Ranji1908/Reifendruck-Display-Arduino/docs/bilder/v1_retro/2_alarm.png

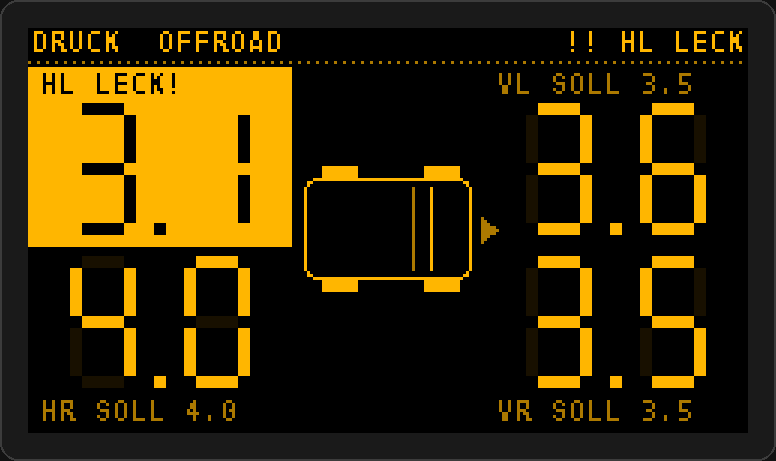
docs/bilder/v1_retro/2_alarm.png
