Ranji1908/Reifendruck-Display-Arduino/docs/bilder/v1_retro/3_temperatur.png

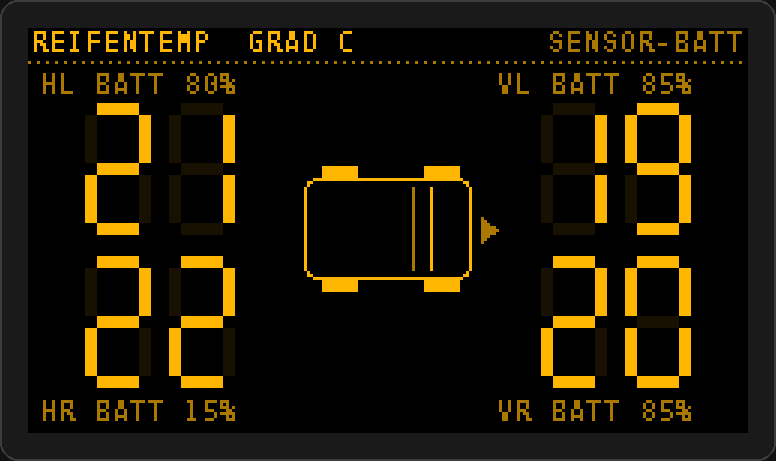
docs/bilder/v1_retro/3_temperatur.png
