Ranji1908/Reifendruck-Display-Arduino/docs/bilder/v1_retro/4_neigung.png

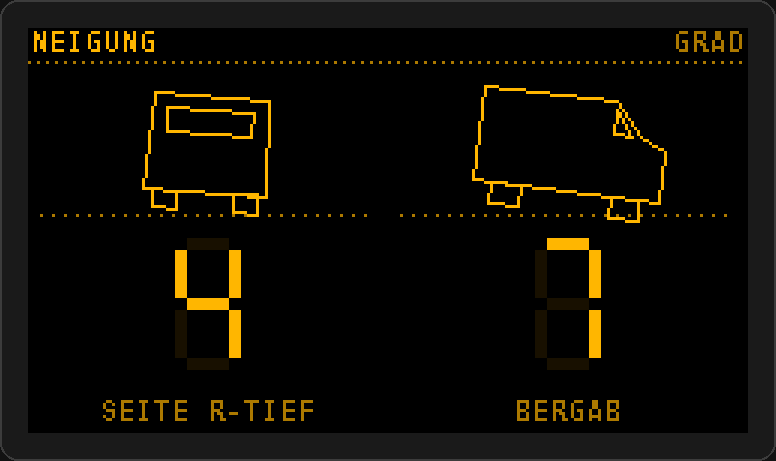
docs/bilder/v1_retro/4_neigung.png
