Ranji1908/Reifendruck-Display-Arduino/docs/bilder/v1_retro/5_kompass.png

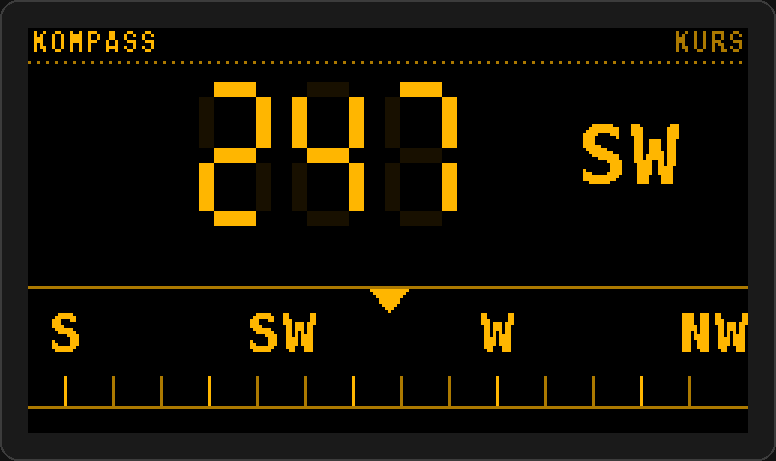
docs/bilder/v1_retro/5_kompass.png
