Ranji1908/Reifendruck-Display-Arduino/docs/bilder/v1_retro/6_bord.png

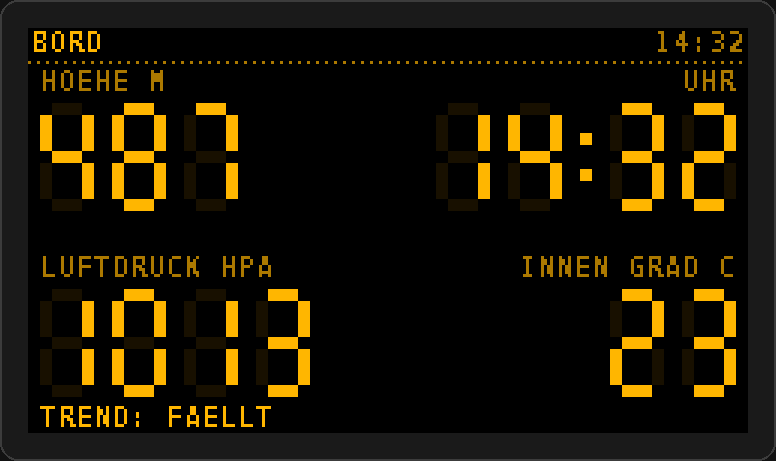
docs/bilder/v1_retro/6_bord.png
