Ranji1908/Reifendruck-Display-Arduino/docs/bilder/v1_retro/7_ausrichten.png

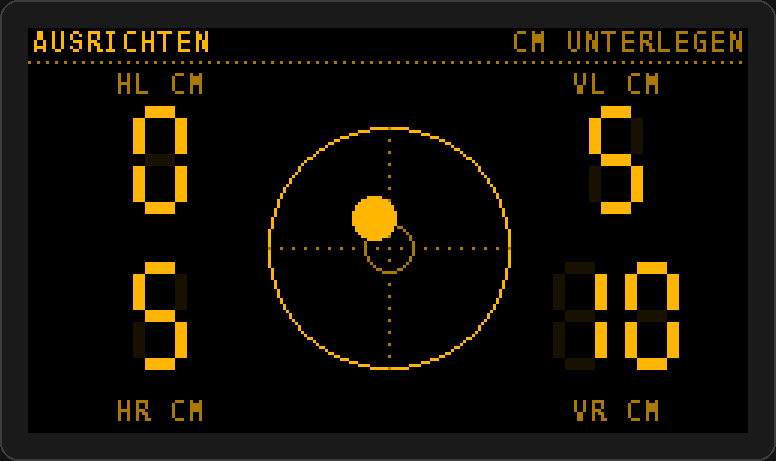
docs/bilder/v1_retro/7_ausrichten.png
