Ranji1908/Reifendruck-Display-Arduino/docs/bilder/v1_retro/8_menue.png

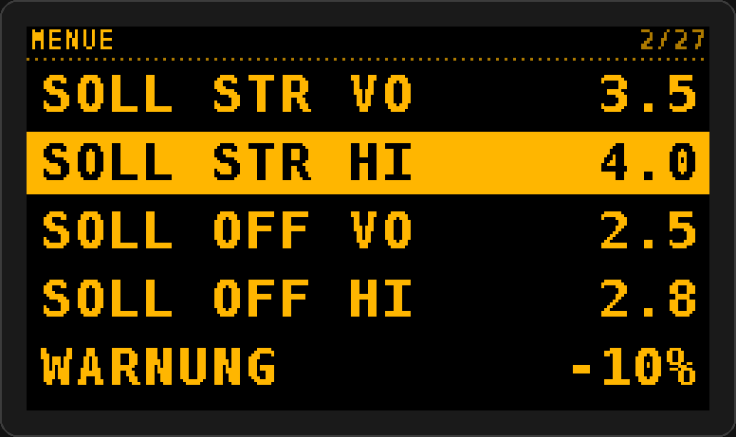
docs/bilder/v1_retro/8_menue.png
