Ranji1908/Reifendruck-Display-Arduino/docs/bilder/v1_retro/9_wert.png

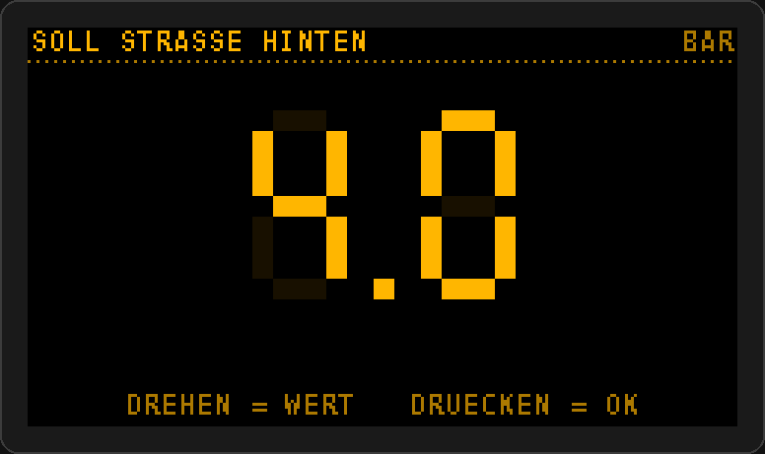
docs/bilder/v1_retro/9_wert.png
