Ranji1908/Reifendruck-Display-Arduino/docs/bilder/v1_retro/10_anlernen.png

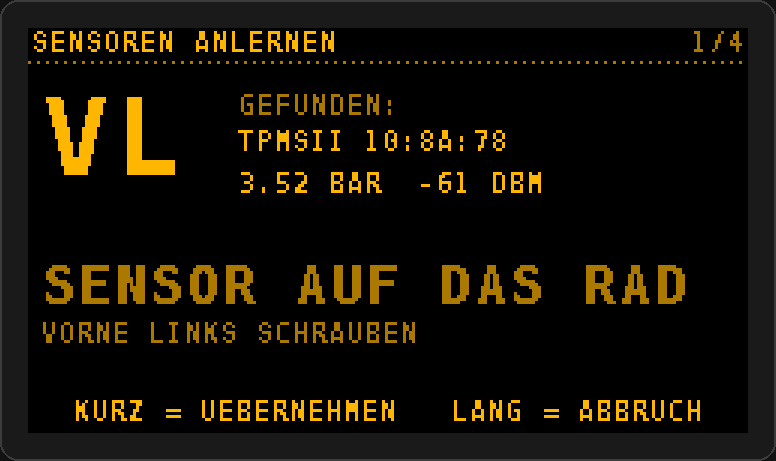
docs/bilder/v1_retro/10_anlernen.png
