Ranji1908/Reifendruck-Display-Arduino/docs/bilder/v2_modern/2_alarm.png

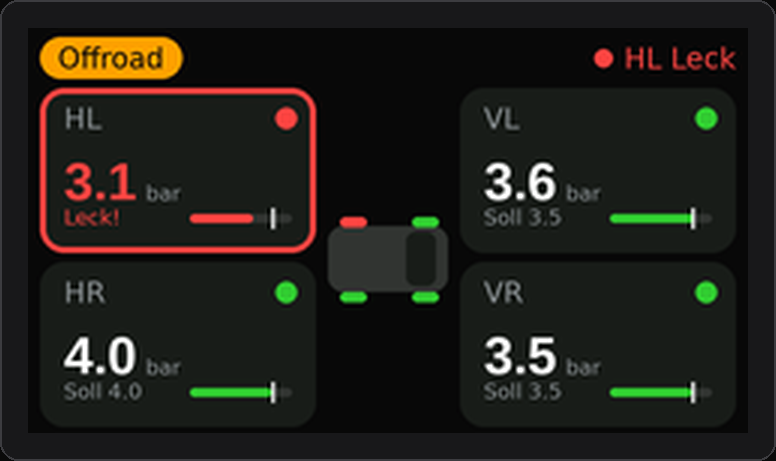
docs/bilder/v2_modern/2_alarm.png
