Ranji1908/Reifendruck-Display-Arduino/docs/bilder/v2_modern/3_temperatur.png

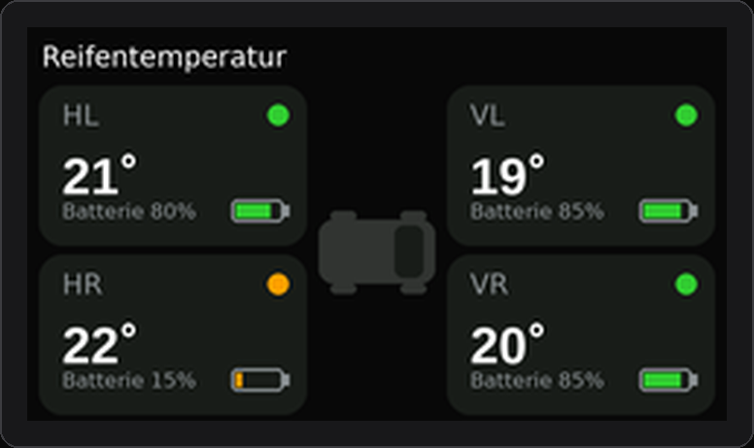
docs/bilder/v2_modern/3_temperatur.png
