Ranji1908/Reifendruck-Display-Arduino/docs/bilder/v2_modern/4_neigung.png

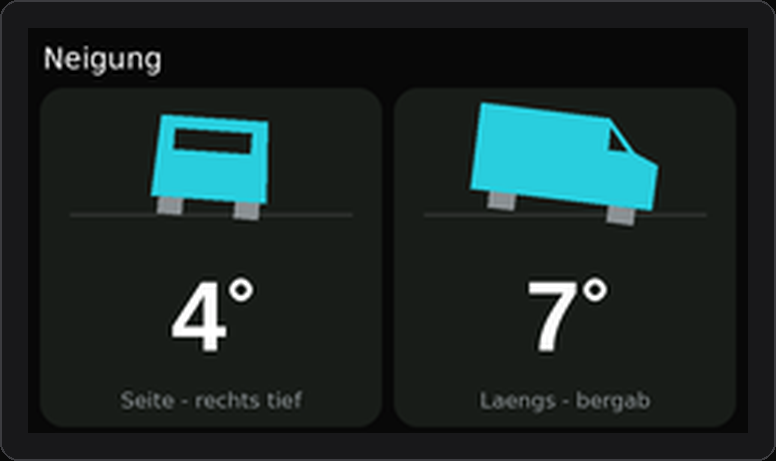
docs/bilder/v2_modern/4_neigung.png
