Ranji1908/Reifendruck-Display-Arduino/docs/bilder/v2_modern/5_kompass.png

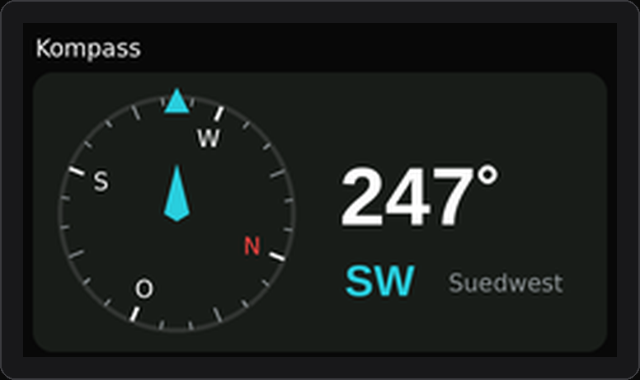
docs/bilder/v2_modern/5_kompass.png
