Ranji1908/Reifendruck-Display-Arduino/docs/bilder/v2_modern/6_bord.png

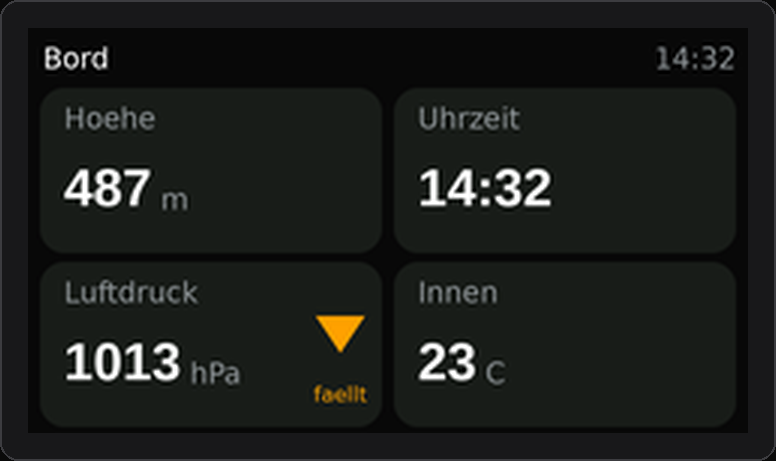
docs/bilder/v2_modern/6_bord.png
