Ranji1908/Reifendruck-Display-Arduino/docs/bilder/v2_modern/7_ausrichten.png

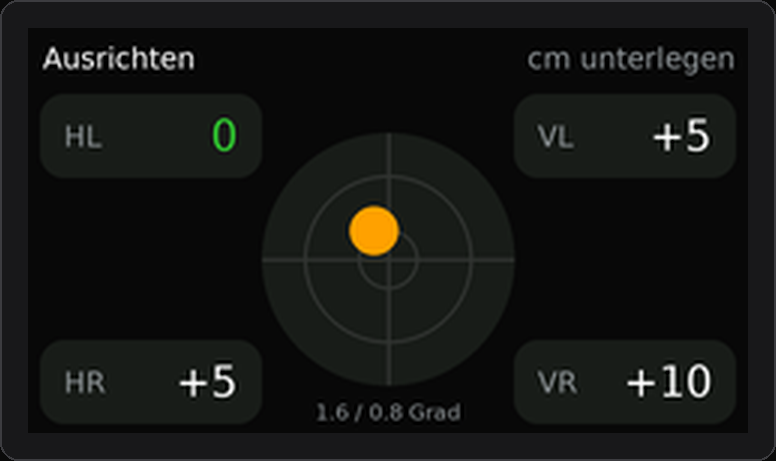
docs/bilder/v2_modern/7_ausrichten.png
