Ranji1908/Reifendruck-Display-Arduino/docs/bilder/v2_modern/8_menue.png

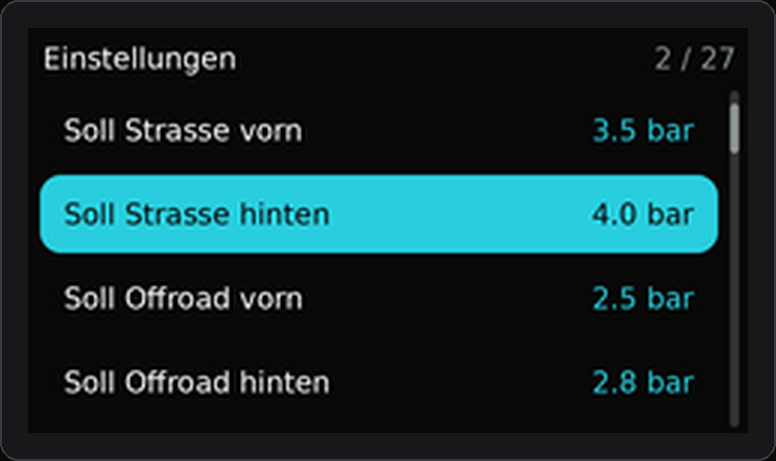
docs/bilder/v2_modern/8_menue.png
