Ranji1908/Reifendruck-Display-Arduino/docs/bilder/v2_modern/9_wert.png

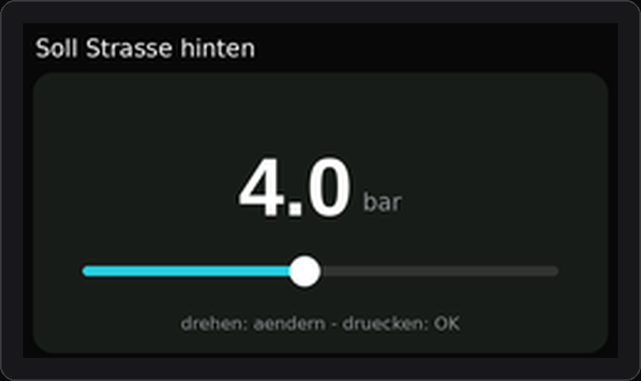
docs/bilder/v2_modern/9_wert.png
