Ranji1908/Reifendruck-Display-Arduino/docs/bilder/v2_modern/10_anlernen.png

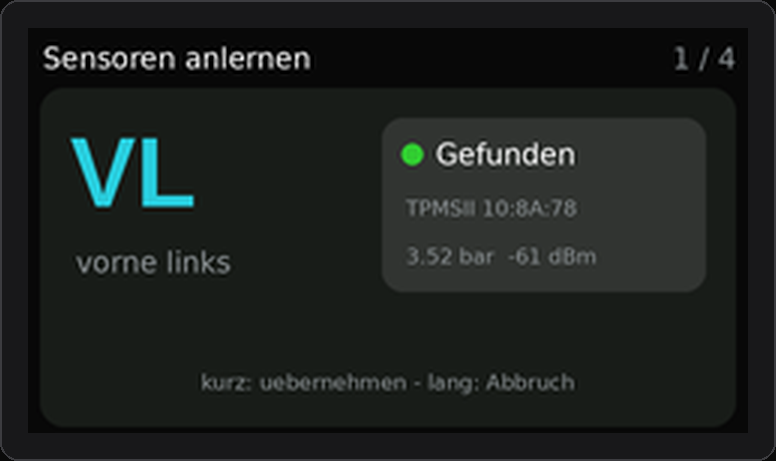
docs/bilder/v2_modern/10_anlernen.png
