Ranji1908/Reifendruck-Display-Arduino/hardware/stl/aufbau_15grad.stl

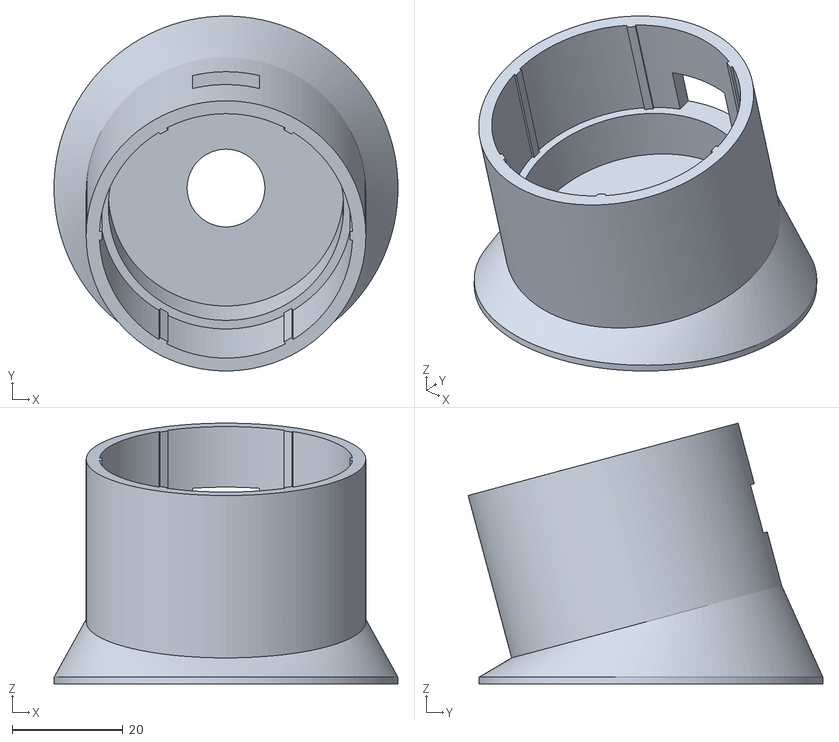
[picture p23: CAD file, 2026-11-07, last stored version]
hardware/stl/aufbau_15grad.stl
62.0 x 64.0 x 47.0
