Ranji1908/Reifendruck-Display-Arduino/hardware/stl/aufbau.stl

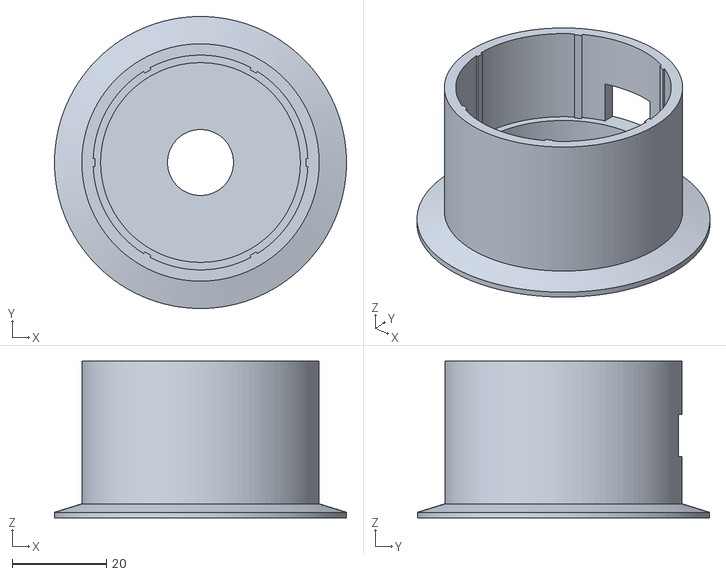
[picture p24: CAD file, 2026-11-07, last stored version]
hardware/stl/aufbau.stl
62.0 x 62.0 x 33.3
