Ranji1908/Reifendruck-Display-Arduino/hardware/stl/testring.stl

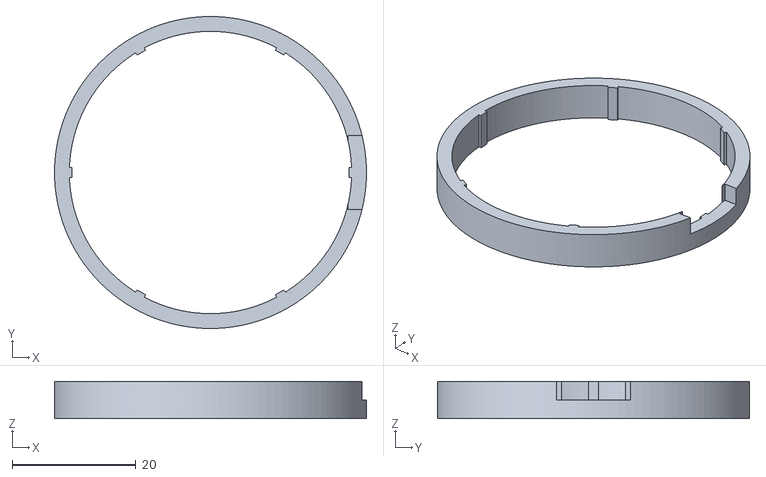
[picture p25: CAD file, 2026-11-07, last stored version]
hardware/stl/testring.stl
50.4 x 50.4 x 6.00
