Ranji1908/Reifendruck-Display-Arduino/hardware/stl/einbau.stl

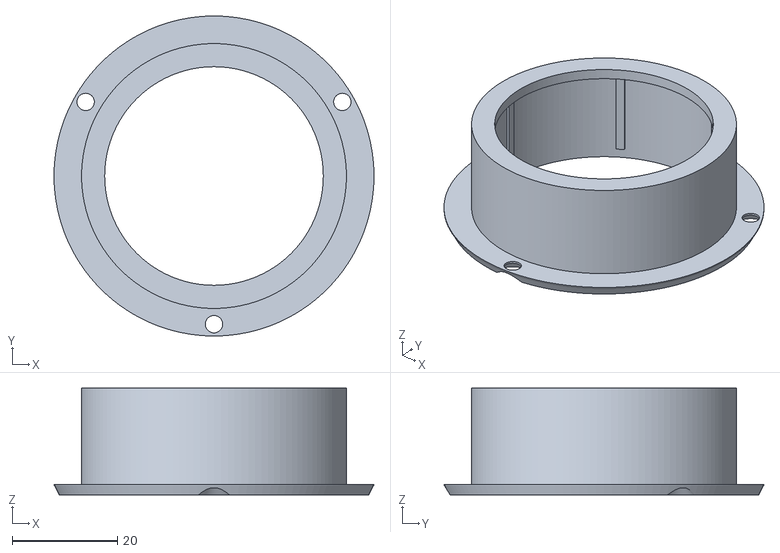
[picture p26: CAD file, 2026-11-07, last stored version]
hardware/stl/einbau.stl
60.9 x 60.9 x 20.3
