Ranji1908/Reifendruck-Display-Arduino/hardware/stl/schablone.stl

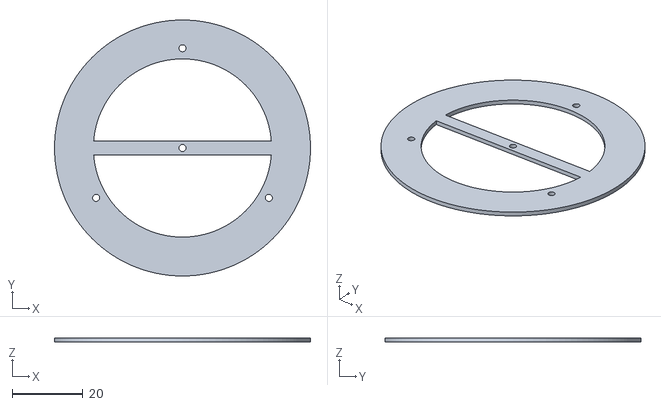
[picture p27: CAD file, 2026-11-07, last stored version]
hardware/stl/schablone.stl
72.4 x 72.4 x 1.20
