Ranji1908/Reifendruck-Display-Arduino/(commit log)

2026-11-07 Reifendruck-Display: ESP32-Firmware mit BLE-TPMS, OLED, Strasse/Offroad und Warnungen
    - Kernlogik (Dekoder, Warnstufen mit Hysterese, Leck-Erkennung, Quittierung) hardwareunabhaengig mit Unit-Tests
    - Firmware: NimBLE-Scan, U8g2-Anzeige mit Fahrzeug-Draufsicht, Drehgeber-Menue, Sensor-Anlernen, Demo-Modus
    - Bauanleitung mit Einkaufsliste, Verkabelung und Einbauhinweisen
    Claude-Session: https://claude.ai/code/session_016HV1nXVVaypXb9uTVZqB8N
2026-11-07 M5Stack-Dial-Variante mit Neigungsmesser, 6 Sensortypen, 3D-Druck-Haltern und Teileliste
    - Neue Firmware fuer den M5Stack Dial: Seiten Reifen / Neigung / Ausrichten, rundes Menue,
    Anlernen, Kalibrierung des Lagesensors (Unit IMU an Port A), Demo-Modus
    - Dekoder fuer 6 verbreitete BLE-Reifensensoren (Formate nach bkbilly/tpms_ble)
    - Neigungsberechnung fuer beliebige Einbaulage und Keil-Rechner fuers Ausrichten, mit Tests
    - Gemeinsamer BLE-Empfang in include/BleTpms.h; OLED-Variante nach src/oled verschoben
    - Parametrische OpenSCAD-Halter (Aufbau, Aufbau 15 Grad, Einbau-Blende, Testring, Schablone) mit STL
    - TEILELISTE.md und ueberarbeitete Anleitung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
    [aufbau.stl, aufbau_15grad.stl, einbau.stl, m5dial_halter.scad, schablone.stl, testring.stl]
2026-11-08 Umstieg auf rechteckiges Touch-Display (M5Stack Core2/CoreS3), runde Variante entfernt
    - Neue Firmware src/core: 320x240-Layout, Touch-Bedienung mit Tippzonen und Bedienleiste,
    Core2-Tastenpunkte, interner Lagesensor (MPU6886/BMI270) mit Fallback auf Unit IMU an Port A
    - M5Dial-Firmware und 3D-Druck-Halter entfernt (bleiben in der Git-Historie)
    - Teileliste und Anleitung fuer Core2 inkl. Einbau mit Dual Lock, Vorschaubilder der Hauptseite
    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
    [aufbau.stl, aufbau_15grad.stl, einbau.stl, m5dial_halter.scad, schablone.stl, testring.stl]
2026-11-08 Umstieg auf M5Stack DinMeter v1.1 (Einbau im 1/32-DIN-Ausschnitt)
    - Neue Firmware src/dinmeter: 240x135-Layout, Drehknopf-Bedienung, 6-36 V direkt,
    Neigung ueber Unit IMU an Port A
    - Core2-Variante entfernt (bleibt in der Git-Historie)
    - Teileliste mit Einbau in Blindblende, Temperaturhinweis, neue Vorschaubilder
    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
2026-11-08 Retro-Design (Bernstein, 7-Segment), sechs Seiten inkl. Kompass und Bord-Daten
    - Seiten: Druck, Reifentemperatur, Neigung, Kompass, Bord (Hoehe/Uhr/Luftdruck/Innentemp.), Ausrichten
    - Transporter quer, Warnungen invertiert, 7-Segment-Ziffern mit Geister-Segmenten
    - Unit Mini IMU-Pro: Kompass (neigungskompensiert, Kalibrierfahrt), BMP280-Luftdruck, Hoehe, Wettertrend
    - Uhr ueber eingebaute RTC, Menue fuer Kompass/Hoehe/Uhr
    - Kernlogik: Kompass, BMP280-Kompensation, Hoehenformel, Drucktrend mit Tests (26 Tests)
    - Vorschau aller Seiten (docs/bilder, Generator in tools/)
    Claude-Session: https://claude.ai/code/session_016HV1nXVVaypXb9uTVZqB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
2026-11-08 V2: modernes Design als Alternative, umschaltbar im Menue
    - ui_modern.inc: Karten-Layout, Statusfarben, Fuellbalken zum Solldruck, Kompassrose,
    Kacheln fuer Bord-Daten, Schieberegler im Editor - gleiche Werte und Seiten wie Retro
    - Menuepunkt Design (Retro/Modern), Einstellung theme in Settings
    - Vorschauen beider Designs unter docs/bilder/v1_retro und v2_modern, Generatoren in tools/
    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
2026-11-08 Teileliste: vollstaendige Einkaufsliste mit Mengen, Strom- und Einbaumaterial
    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
2026-11-08 Luftdrucksensor auch ohne Lagesensor suchen; Alternativen zur ausverkauften Mini IMU-Pro
    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
2026-11-08 M5Stack-Bezug: 9-DoF IMU (BMM350-Kompass) und QMP6988-Luftdruck unterstuetzt
    - Bosch BMM350 SensorAPI als Bibliothek (BSD-3), Anbindung ueber Port A
    - QMP6988-Kompensation (Rechenweg aus M5Unit-ENV, MIT), per Vergleichstest identisch zum Original
    - Luftdrucksensor-Erkennung: BMP280 oder QMP6988, Kompass: BMM150 oder BMM350
    - Teileliste nach Bezugsquellen: M5Stack-Shop, Amazon (Reifensensoren), Baumarkt
    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
2026-11-09 Teileliste: Bestellvariante BerryBase (DinMeter, IMU, ENV III, HUB)
    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
